joaquincapellancruz/IoT-LoRaWAN-Cistern-Monitor/(commit log)

2026-01-24 Update README.md
    New material
2026-01-24 Integración masiva de sx1302_hal respetando licencias de Semtech y terceros
2026-01-24 Integración masiva de lora_gateway cumpliendo licencias de Semtech y Parson
    [library.cfg]
